openxc/shiftknob-3Ddesign/Components/pcb_assembly.stp

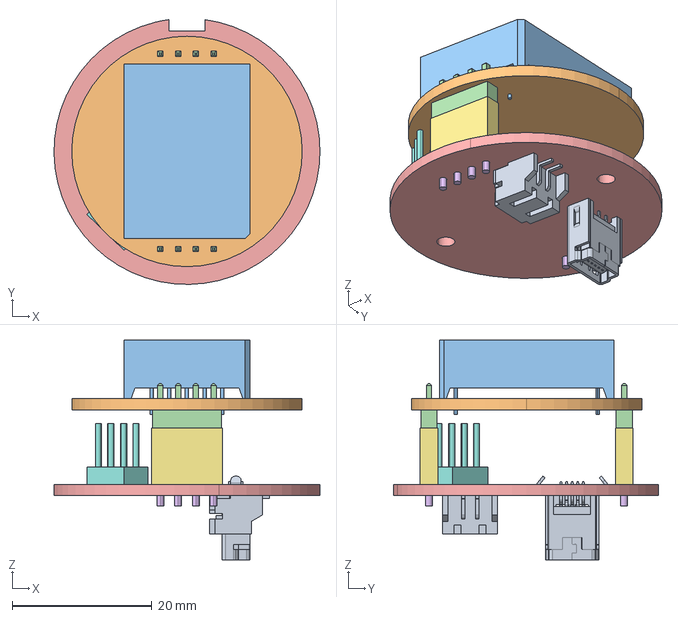
[picture p1: CAD file, 2013-06-11]
Components/pcb_assembly.stp
38.1 x 37.9 x 31.5 mm
