openxc/shiftknob-3Ddesign/Components/xbox_motor.stp

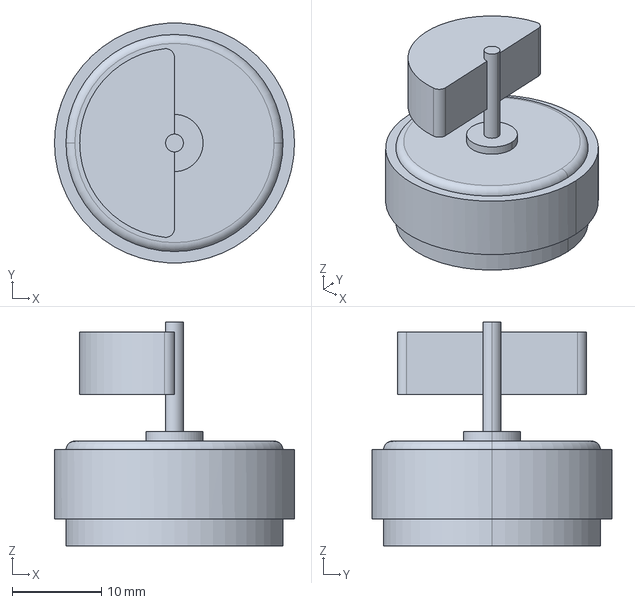
[picture p2: CAD file, 2013-06-11]
Components/xbox_motor.stp
26.9 x 26.9 x 25.1 mm
