openxc/shiftknob-3Ddesign/Figo/figo_base.stl

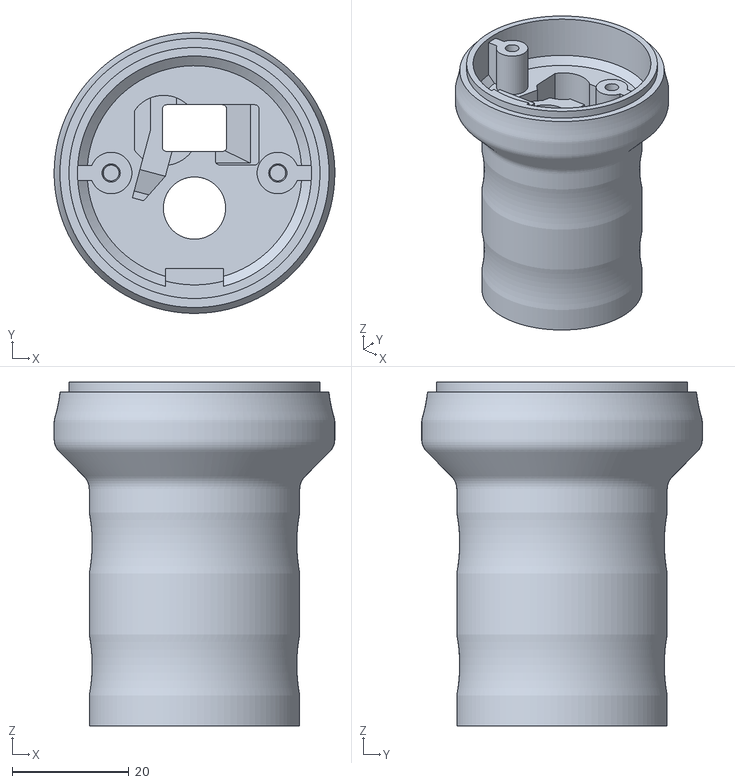
[picture p3: CAD file, 2013-06-11]
Figo/figo_base.stl
48.0 x 48.0 x 58.8
