openxc/shiftknob-3Ddesign/FocusST/FocusST_top.stl

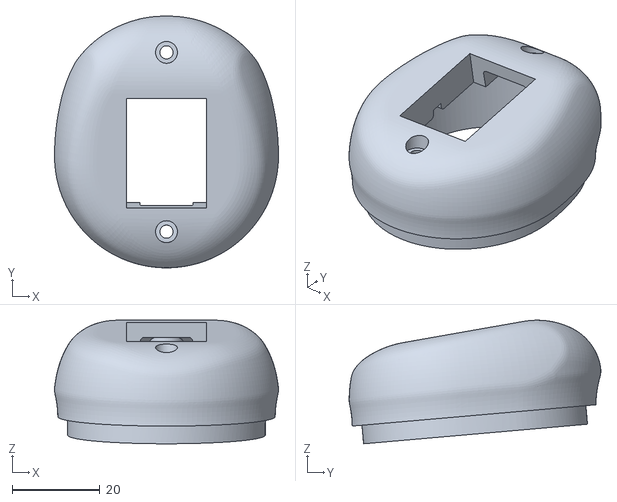
[picture p4: CAD file, 2013-06-11]
FocusST/FocusST_top.stl
51.1 x 57.4 x 28.2
