openxc/shiftknob-3Ddesign/Figo/figo_diffuser.stl

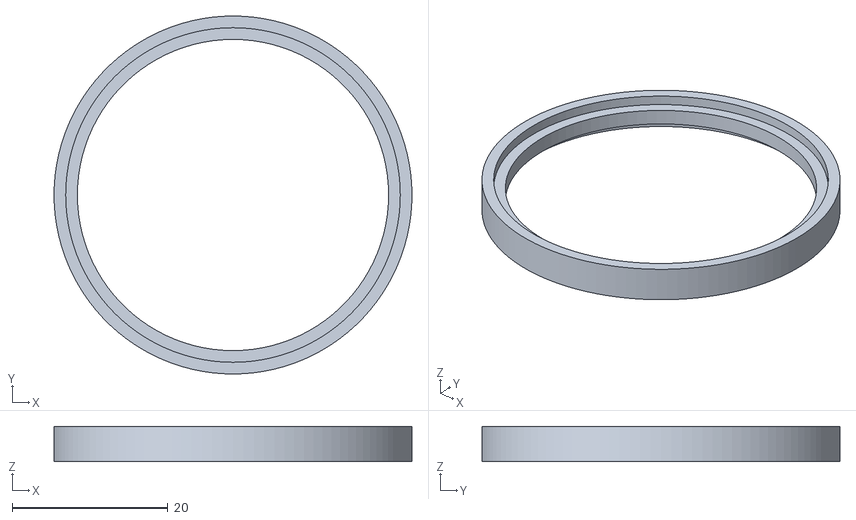
[picture p5: CAD file, 2013-06-11]
Figo/figo_diffuser.stl
45.9 x 45.9 x 4.50
