openxc/shiftknob-3Ddesign/Components/M2.5_insert.stp

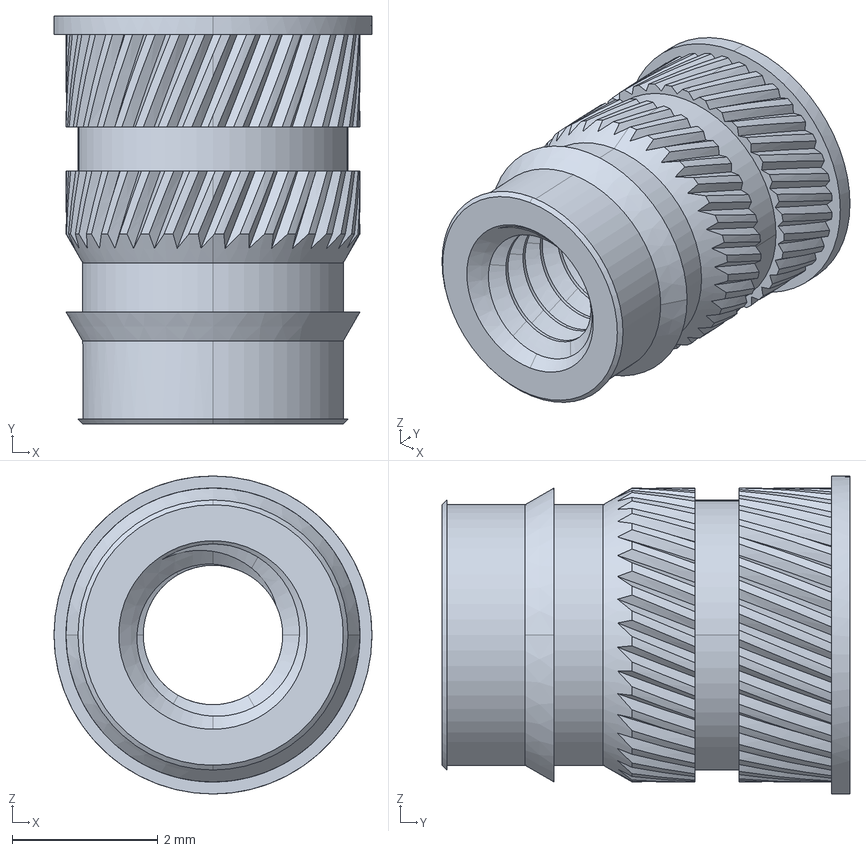
[picture p6: CAD file, 2013-06-11]
Components/M2.5_insert.stp
4.37 x 5.60 x 4.37 mm
