openxc/shiftknob-3Ddesign/Figo/figo_top.stl

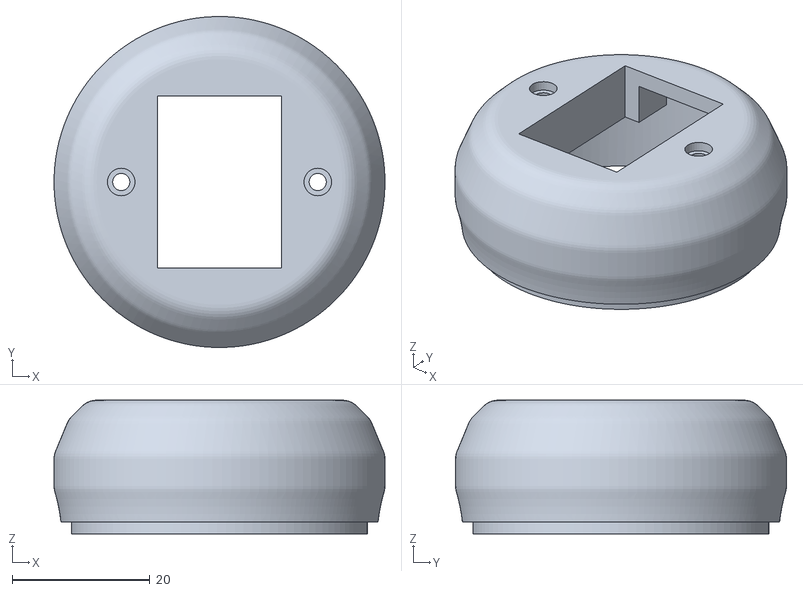
[picture p7: CAD file, 2013-06-11]
Figo/figo_top.stl
48.0 x 48.0 x 19.4
