openxc/shiftknob-3Ddesign/Components/small_toy_motor.stp

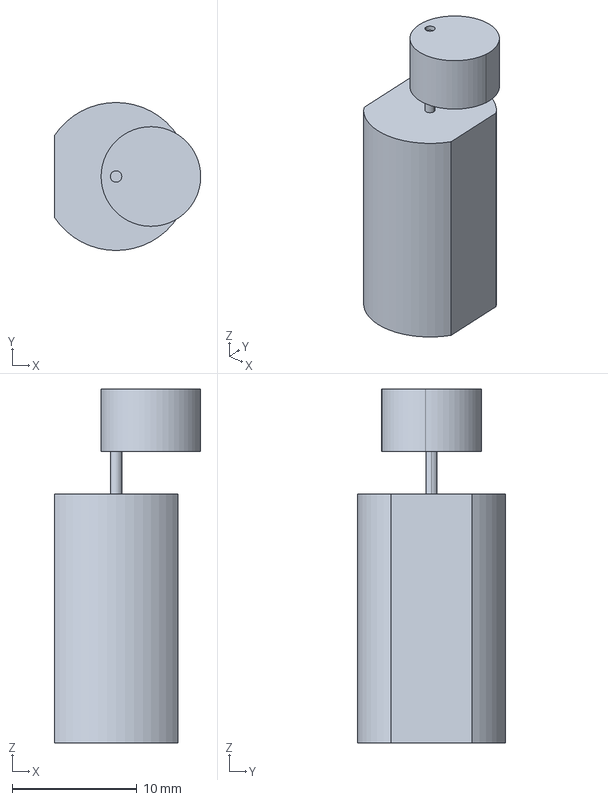
[picture p8: CAD file, 2013-06-11]
Components/small_toy_motor.stp
11.8 x 11.9 x 28.4 mm
