openxc/shiftknob-3Ddesign/Components/M2x20_screw.stp

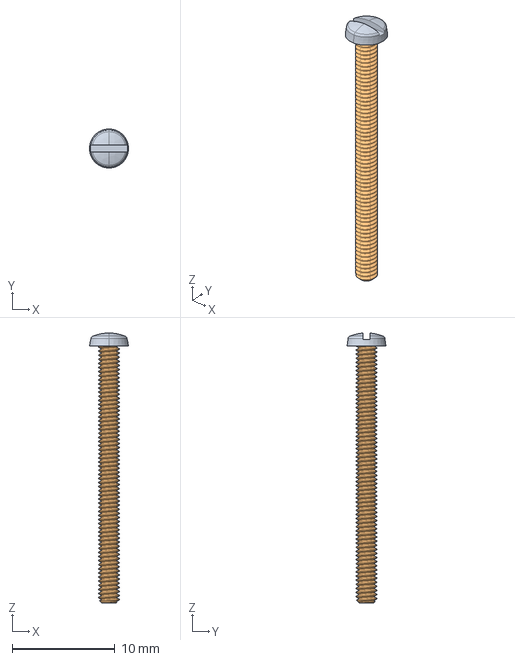
[picture p9: CAD file, 2013-06-11]
Components/M2x20_screw.stp
3.80 x 3.80 x 26.3 mm
