openxc/shiftknob-3Ddesign/Components/M2.5x25_screw.stp

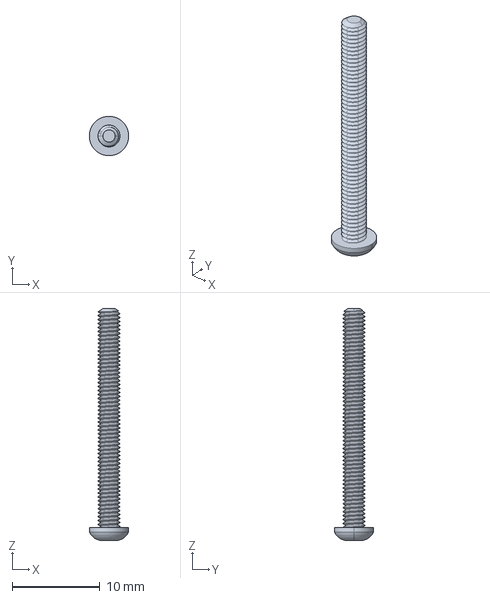
[picture p10: CAD file, 2013-06-11]
Components/M2.5x25_screw.stp
4.50 x 4.50 x 26.5 mm
