openxc/shiftknob-3Ddesign/(list of files, cad)

Other CAD files:
Components/M2.5_insert.stl
Components/pcb_assembly.stl
Components/small_toy_motor.stl
Components/xbox_motor.stl
