openxc/shiftknob-3Ddesign/(commit log)

2013-06-11 initial commit.
    [FocusST_top.stl, M2.5_insert.stl, M2.5_insert.stp, M2.5x25_screw.stp, M2x20_screw.stp, figo_base.stl, figo_diffuser.stl, figo_top.stl]
2013-06-13 add link to thread size website.
2013-06-13 add READMEs to housing folders. Include specifications about hardware needed for assembly.
2013-06-13 update pcb_assembly.
    [pcb_assembly.stl]
